ShihPingLin/OLED_Pedometer_based_on_3-Axis_Accelerometer/README.md

# OLED_Pedometer_based_on_3-Axis_Accelerometer

## Demo精簡版
https://youtu.be/cfh51k0xcHs \
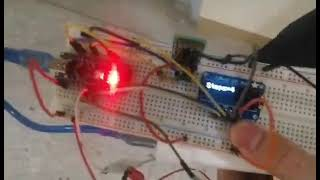
[picture p1: pictures/cover_picture_1.jpg]
Demo (https://youtu.be/cfh51k0xcHs)


## Demo完整版
https://youtu.be/wed2f3X_mXI \
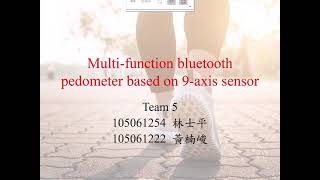
[picture p2: pictures/cover_picture_2.jpg]
Demo2 (https://youtu.be/wed2f3X_mXI)


## 報告
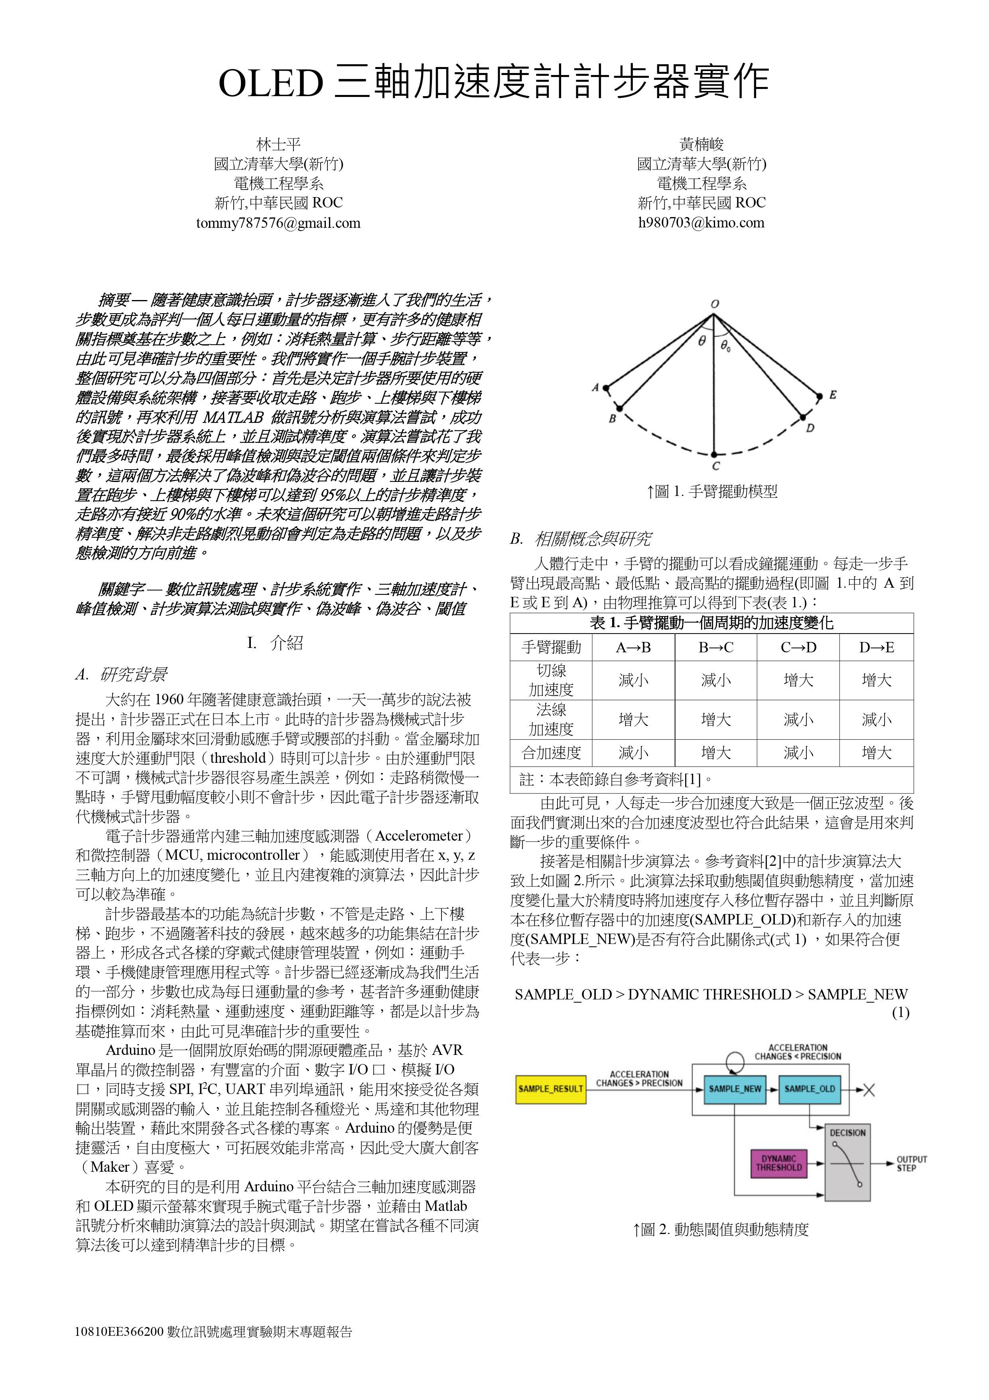
[picture p3: pictures/0001.jpg]
page1

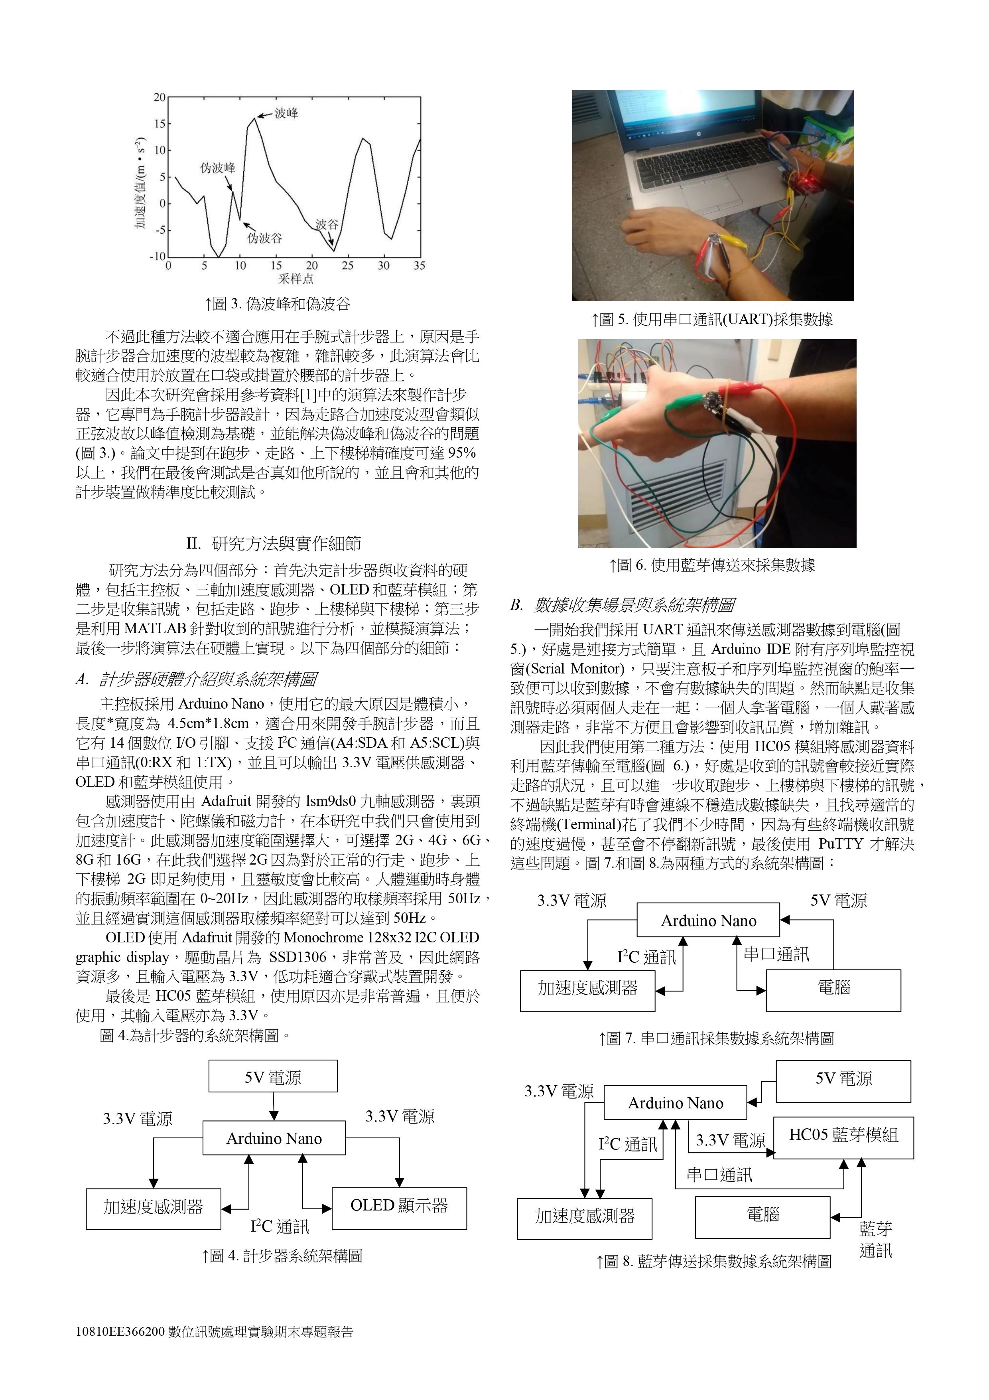
[picture p4: pictures/0002.jpg]
page2

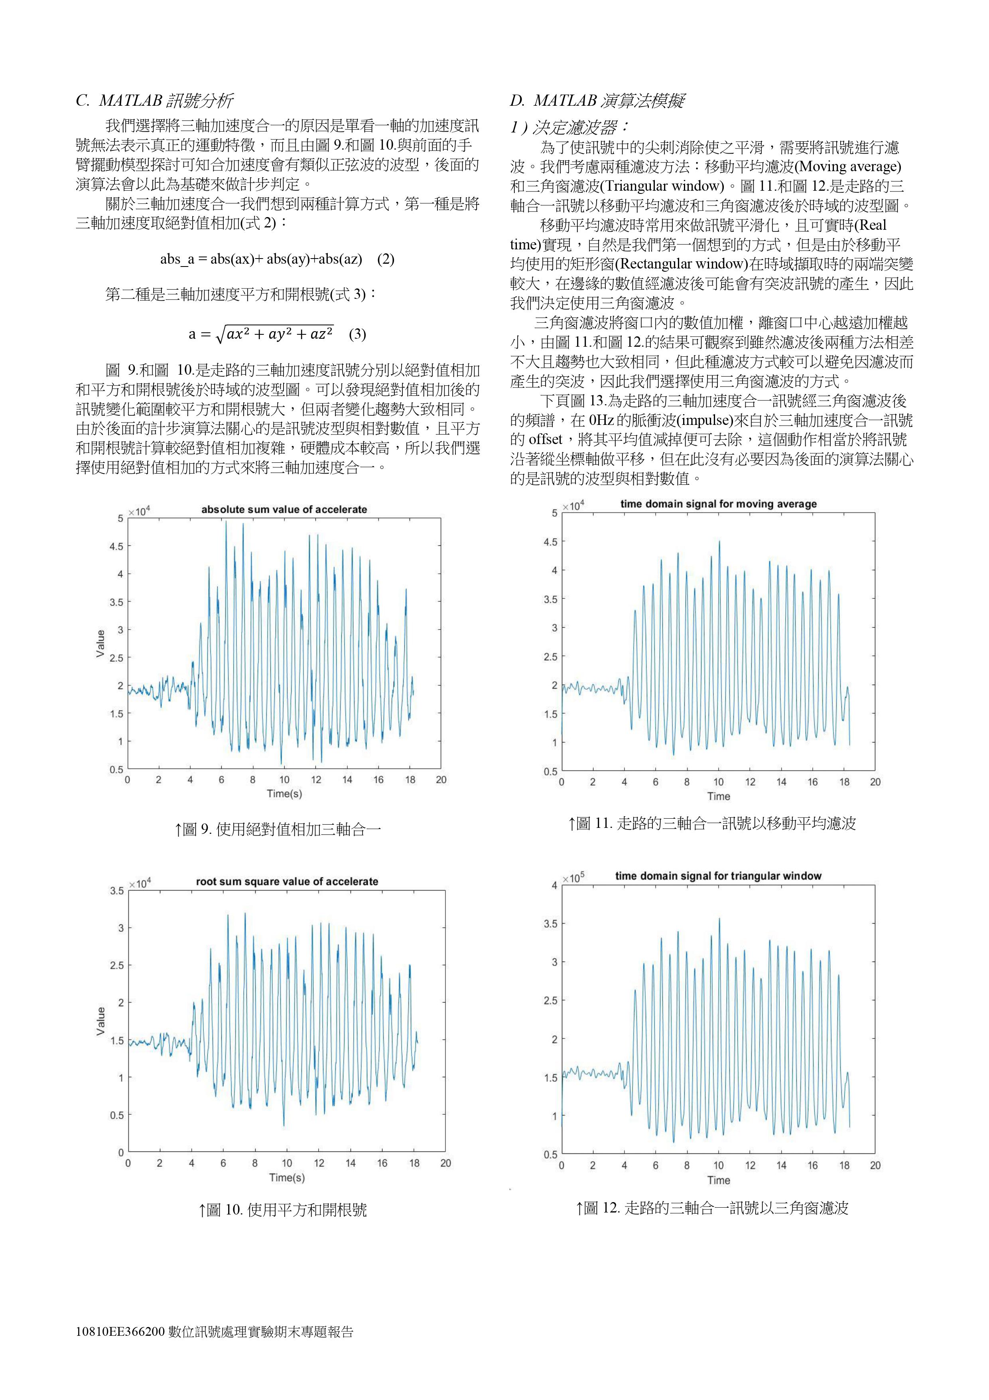
[picture p5: pictures/0003.jpg]
page3

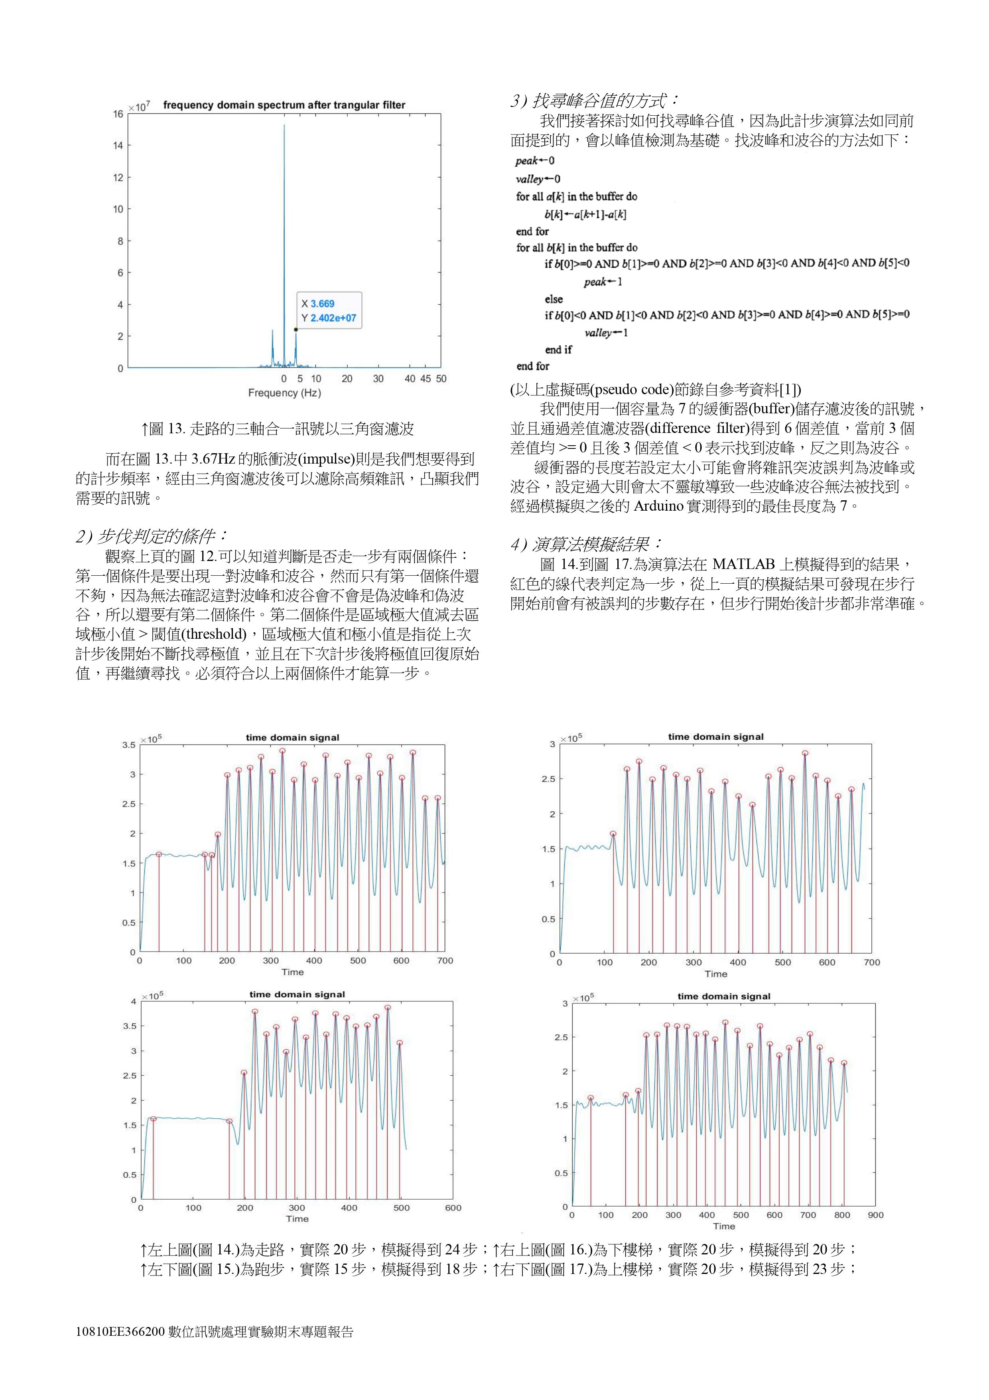
[picture p6: pictures/0004.jpg]
page4

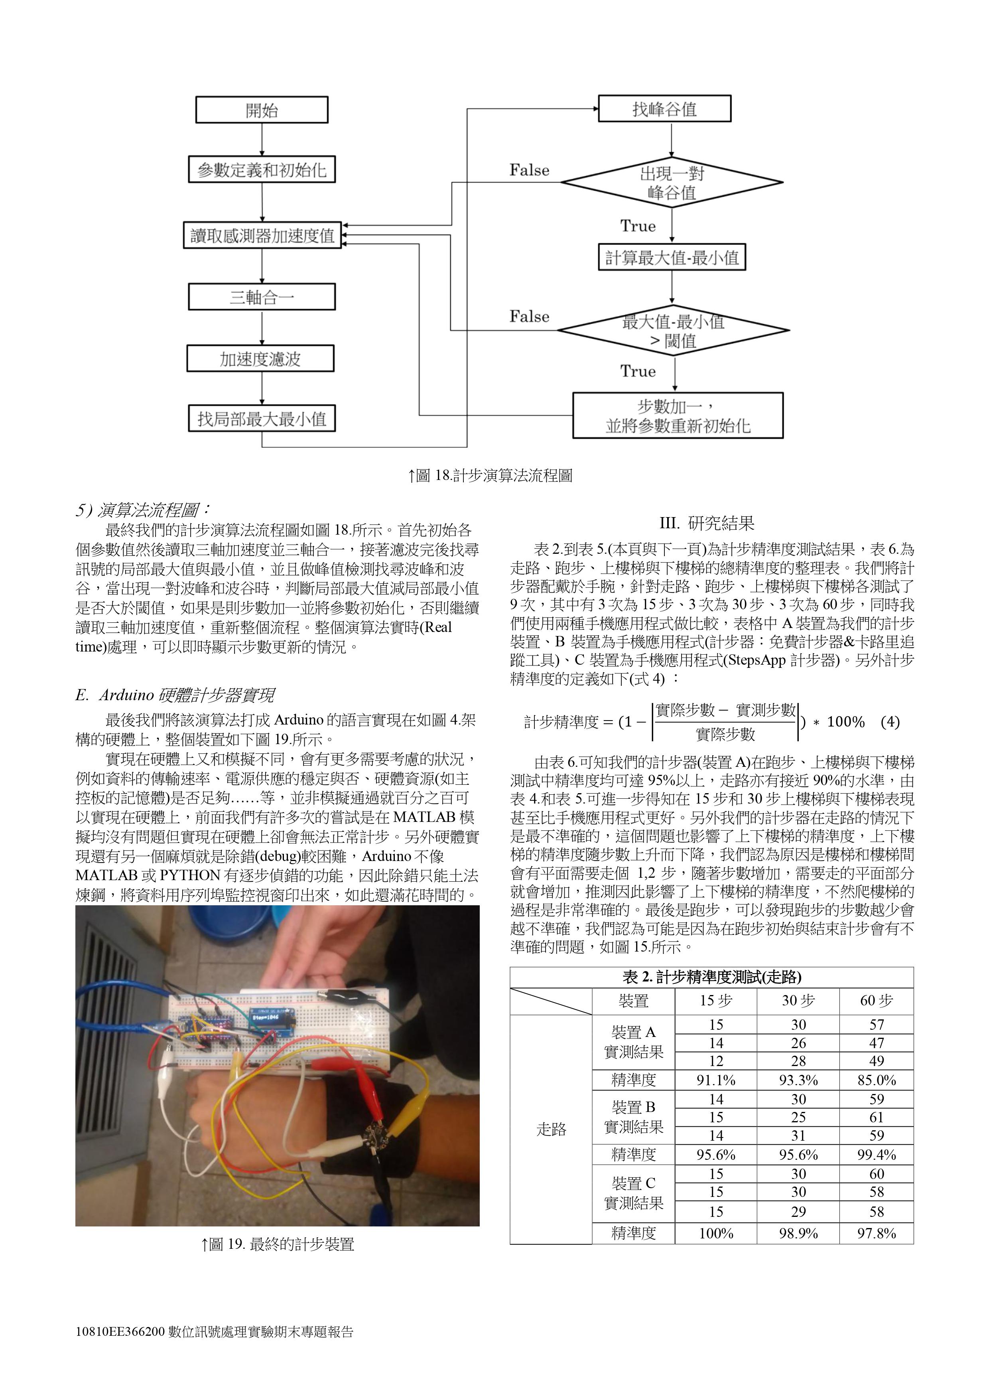
[picture p7: pictures/0005.jpg]
page5

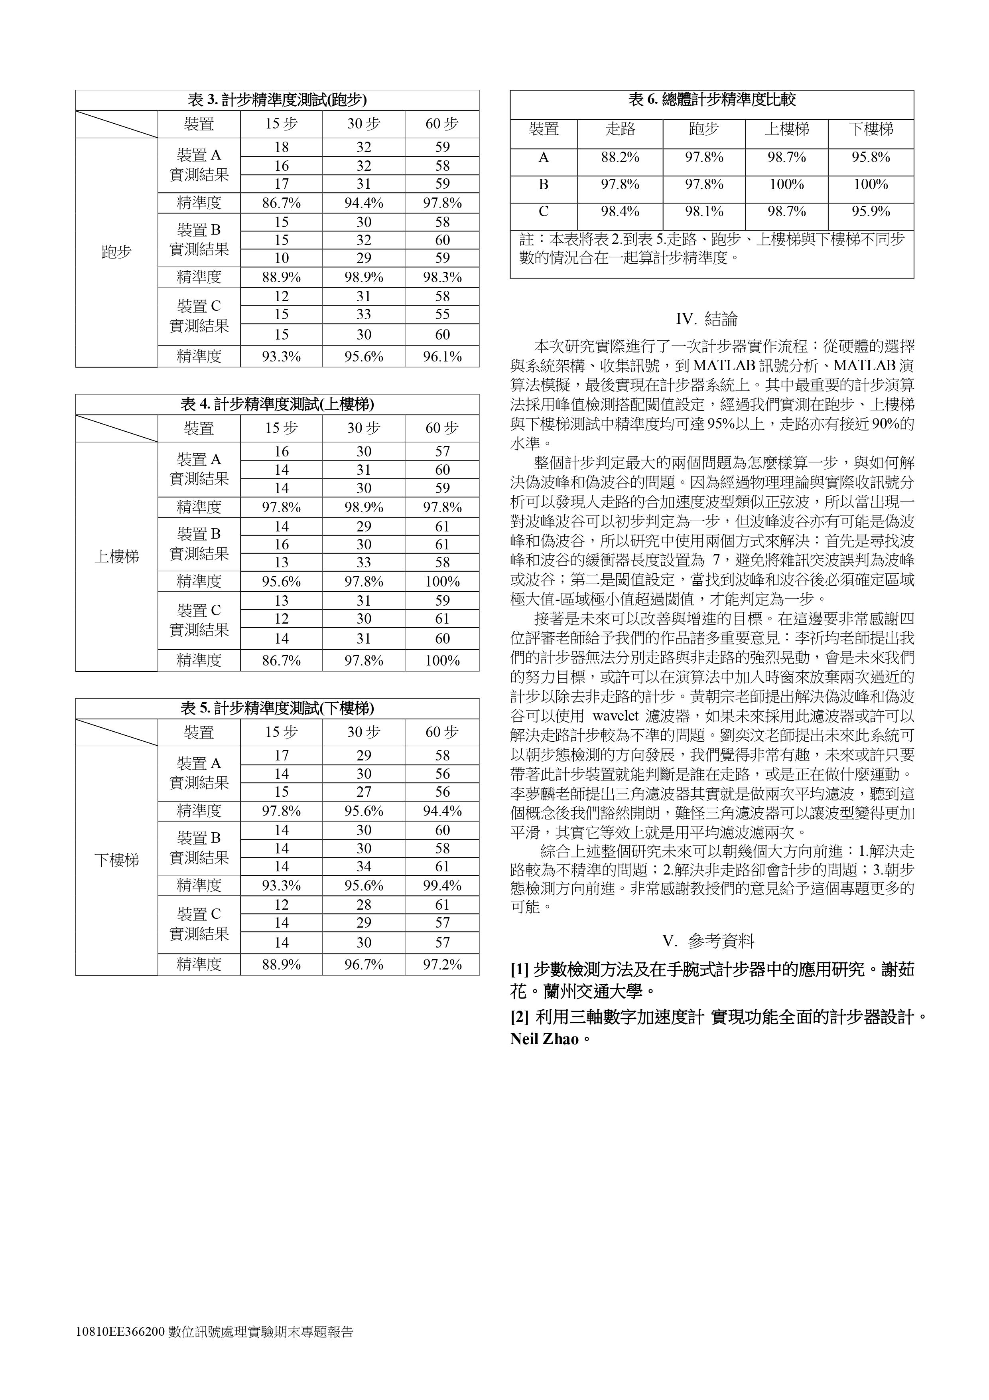
[picture p8: pictures/0006.jpg]
page6
