ShihPingLin/OLED_Pedometer_based_on_3-Axis_Accelerometer/demo_ppt.pptx

## Multi-function bluetooth pedometer based on 9-axis sensor

Team 5
105061254 林士平
105061222 黃楠峻

## Algorithm

開始

找峰谷值

出現一對
峰谷值

參數定義和初始化

False

讀取感測器加速度值

True

計算最大值-最小值

最大值-最小值 > 閾值

步數加一，
並將參數重新初始化

加速度濾波

三軸合一

False

加速度濾波

True

找局部最大最小值

## Method

1. Collect signal from sensor
2. Signal Analysis in Matlab
3. Algorithm simulation in Matlab
4. Implement Algorithm in Arduino

## Collect Signal

- Strategy
Obtain signal from accelerometer through ADC of Arduino
board (similar to Unit 1)

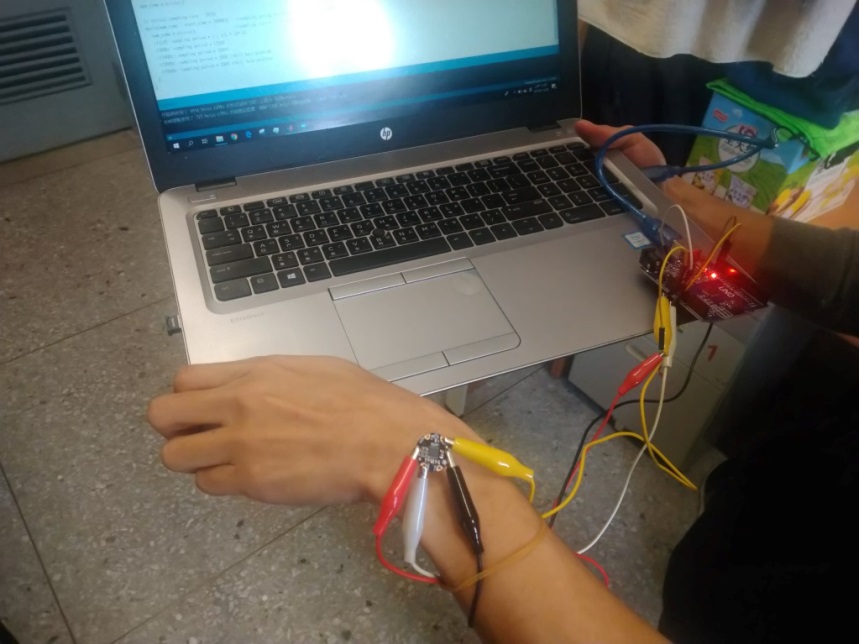
[picture p9: figure]
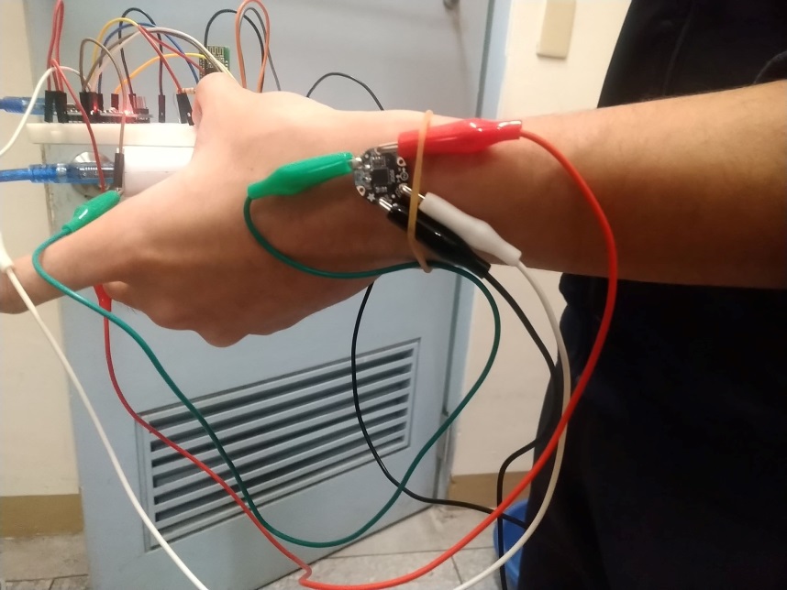
[picture p10: figure]

## Signal Analysis

- Triangular filter vs. Moving average

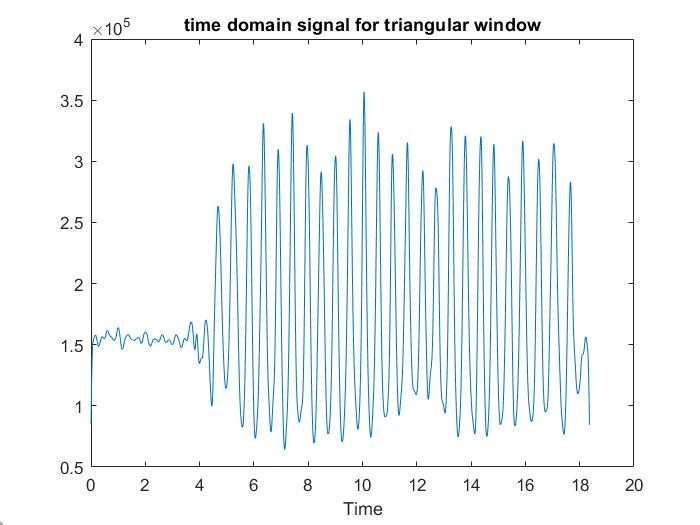
[picture p11: figure]
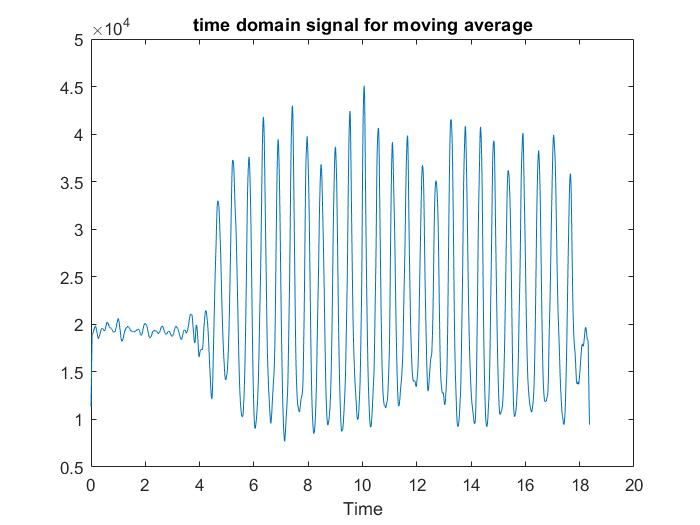
[picture p12: figure]

## Signal Analysis

- Frequency domain of signal after triangular filtering

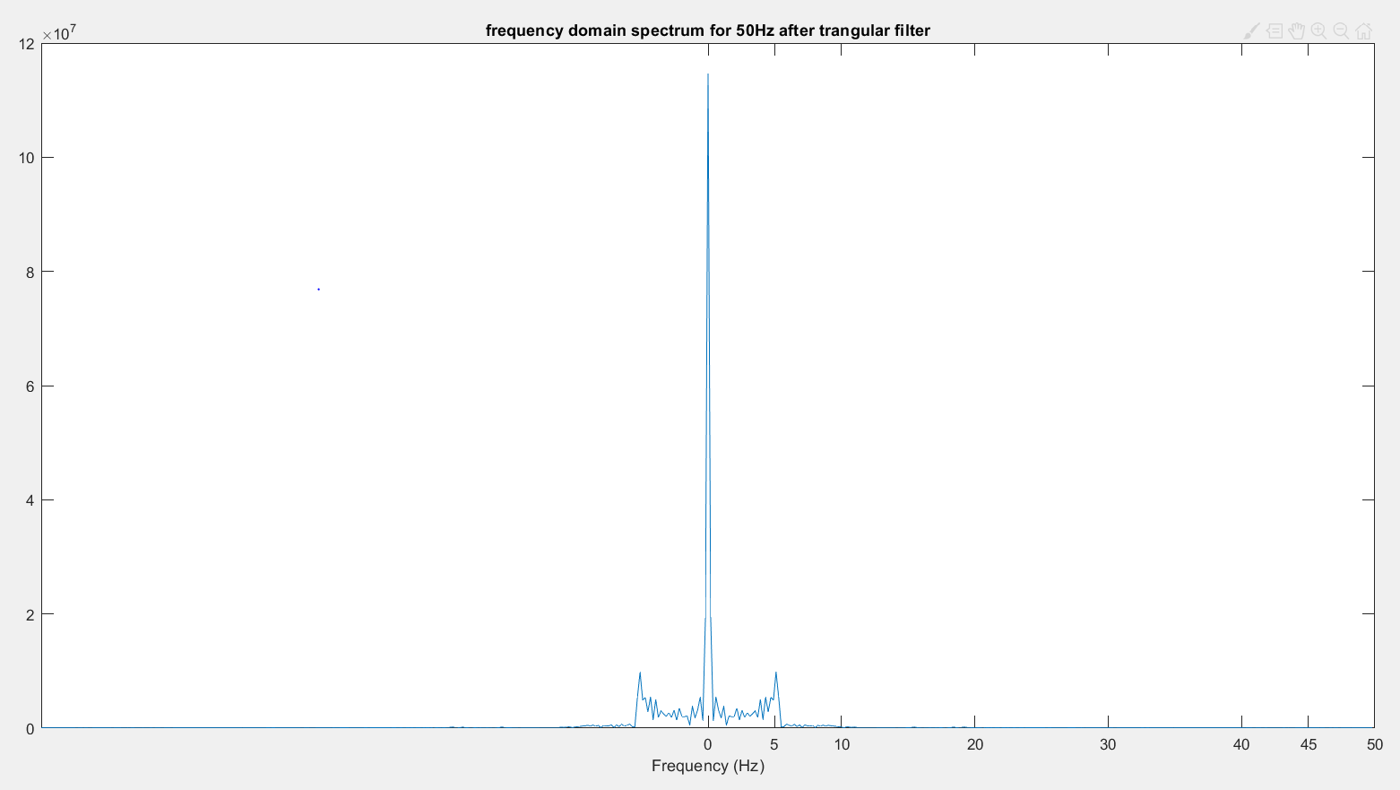
[picture p13: figure]

## Algorithm simulation

- Step of walk and run

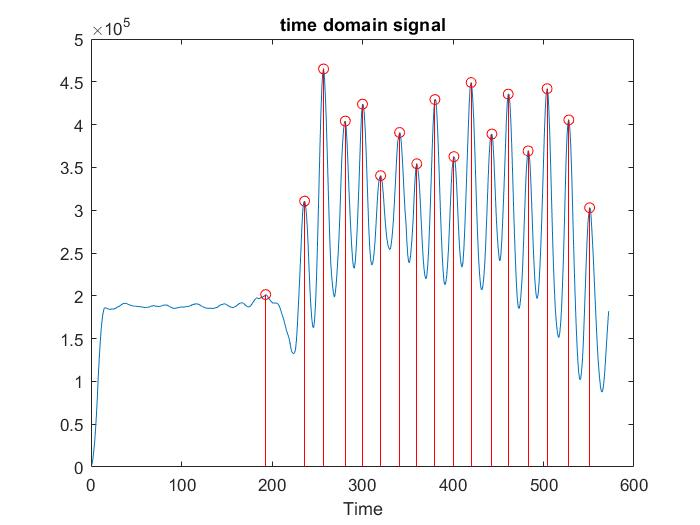
[picture p14: figure]
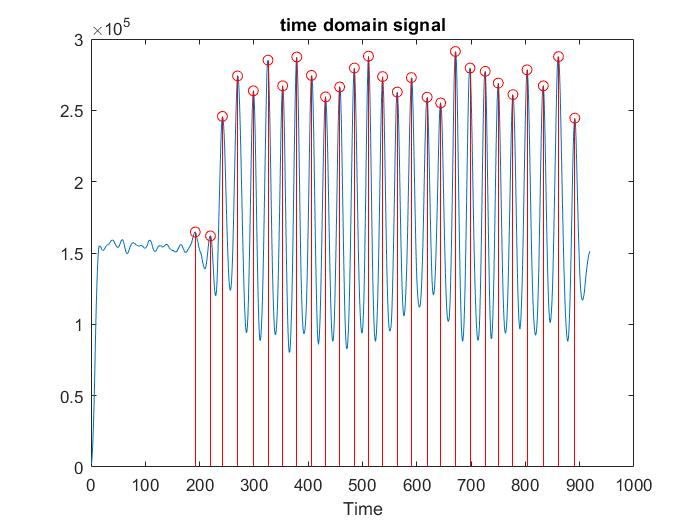
[picture p15: figure]

Walk

Run

## Algorithm simulation

- Step of downstairs and upstairs

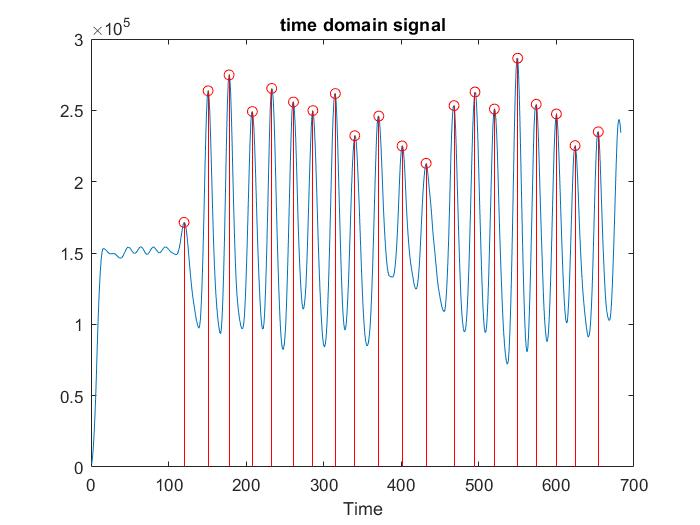
[picture p16: figure]
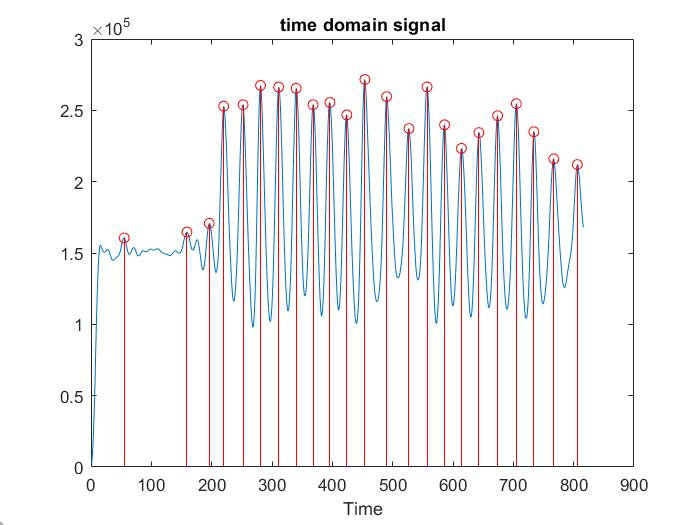
[picture p17: figure]

Downstairs

Upstairs

## Implementation

- Video

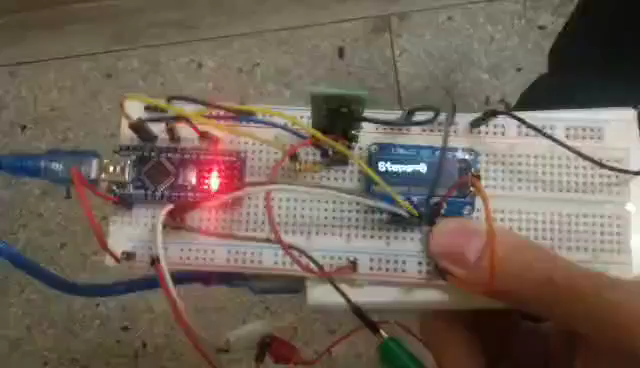
[picture p18: figure]
